neilgibsonpinto-art/Brushed-esc/stmesc.csv

Reference | Qty | Value | Footprint
C1,C2 | 2 | 270uF 35V | Capacitor_SMD:CP_Elec_8x10.5 | https://rajivelectronics.com/product/220-f-35v-smd-aluminum-electrolytic-capacitor
C3,C4 | 2 | 100nF 50V | Capacitor_SMD:C_0603_1608Metric | https://robu.in/product/100nf-603-surface-mount-multilayer-ceramic-capacitorreel-of-4000/
C7 | 1 | 22uF | Capacitor_SMD:C_0603_1608Metric | https://robu.in/product/cl10a226mp8nune-samsang-10v-22uf-x5r-%C2%B120-0603-multilayer-ceramic-capacitors-mlcc-smd-smt-rohs/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
C8 | 1 | 100nF | Capacitor_SMD:C_0603_1608Metric | https://robu.in/product/100nf-0603-surface-mount-multilayer-ceramic-capacitor-pack-of-40/
C9 | 1 | 1uF | Capacitor_SMD:C_0603_1608Metric | https://robu.in/product/0603b105k250nt-fh-25v-1uf-x7r%c2%b110-0603-multilayer-ceramic-capacitors-mlcc-smd-smt-rohs/
C10,C11 | 2 | 10nF | Capacitor_SMD:C_0603_1608Metric | https://robu.in/product/10nf-0603-surface-mount-multilayer-ceramic-capacitor-pack-of-50/
C12,C20 | 2 | 100nf | Capacitor_SMD:C_0603_1608Metric | https://robu.in/product/100nf-0603-surface-mount-multilayer-ceramic-capacitor-pack-of-40/
C13 fp issue make 0805 | 1 | 22uf/35v | Capacitor_SMD:C_0603_1608Metric | https://robu.in/product/grm21bc81c226me44l-murata-electronics-16v-22uf-x6s-%c2%b120-0805-multilayer-ceramic-capacitors-mlcc-smd-smt-rohs/
C14,C15 | 2 | 10uf | Capacitor_SMD:C_0603_1608Metric | https://robu.in/product/grm188d71a106ka73d-murata-electronics-10v-10uf-x7t-%c2%b110-0603-multilayer-ceramic-capacitors-mlcc-smd-smt-rohs-2/
C16 | 1 | 0.1uf | Capacitor_SMD:C_0603_1608Metric | https://robu.in/product/ac0603jrx7r9bb104-yageo-cap-ceramic-0-1uf-50v-x7r-5-pad-smd-0603-125c-automotive-aec-q200-t-r/
C21,C22 | 2 | 22uf | Capacitor_SMD:C_0603_1608Metric | https://robu.in/product/cl10a226mp8nune-samsang-10v-22uf-x5r-%c2%b120-0603-multilayer-ceramic-capacitors-mlcc-smd-smt-rohs/
D1,D4,D5 | 3 | LED | LED_SMD:LED_0805_2012Metric | https://robu.in/product/0805-surface-mount-led-red-50-pcs/
D3 | 1 | (15V Zener) | Diode_SMD:D_SOD-123 | https://robu.in/product/bzt52c15-mdd-independent-13-8v15-6v-500mw-15v-sod-123-zener-diodes-rohs/
J2,J3,J5 | 3 | Conn_01x02 | TerminalBlock_Phoenix:TerminalBlock_Phoenix_MKDS-1,5-2-5.08_1x02_P5.08mm_Horizontal | https://robu.in/product/xy306a-5-0-xinya-2-pin-screw-terminal-blockblue/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
J4 | 1 | Conn_01x06 | Connector_PinHeader_2.54mm:PinHeader_1x06_P2.54mm_Vertical
J6 | 1 | Conn_02x03_Odd_Even | Connector_PinHeader_2.54mm:PinHeader_2x03_P2.54mm_Vertical
L1 | 1 | 4.7uH | Inductor_SMD:L_Sunlord_SWPA5040S | https://evelta.com/4-7uh-3a-20-39mohm-inductor-smd/
Q2 | 1 | IRFR5305 | Package_TO_SOT_SMD:TO-252-2 | https://robu.in/product/irfr5305-slkor-60v-30a-35m%CF%8910v-50w-2-5v-1-piece-p-channel-to-252-mosfets-rohs/
R1,R4,R5,R6,R7,R10,R11,R12,R15,R16 | 10 | 1k | Resistor_SMD:R_0603_1608Metric | https://robu.in/product/1k-ohm-1-4w-0603-surface-mount-chip-resistor-pack-of-100/
R2,R3,R9,R14 | 4 | 10k | Resistor_SMD:R_0603_1608Metric | https://robu.in/product/10k-ohm-1-4w-0603-surface-mount-chip-resistor-pack-of-100/
R8,R13 | 2 | 1k 1% | Resistor_SMD:R_0603_1608Metric
R17 | 1 | 100K | Resistor_SMD:R_0603_1608Metric | https://robu.in/product/100k-ohm-1-4w-0603-surface-mount-chip-resistor-pack-of-100/
SW1,SW2,SW3 | 3 | SW_Push | Button_Switch_SMD:SW_SPST_TS-1088-xR025 | https://robu.in/product/1-month-warranty-470/
U1,U2 | 2 | VNH7070BASTR | Package_SO:SOIC-16_3.9x9.9mm_P1.27mm | https://robu.in/product/vnh7070bastr-stmicroelectronics-motor-driver-controller-h-bridge-1-output-4-v-to-28-v-supply-15-a-out-nsoic-16/
U3 | 1 | ESP32-WROOM-32E | RF_Module:ESP32-WROOM-32D
U5 | 1 | AMS1117-3.3 | Package_TO_SOT_SMD:SOT-223-3_TabPin2
U6 | 1 | AP63205WU-7 | neil:SOIC_05WU-7_DIO-M
