neilgibsonpinto-art/Brushed-esc/stmesc.step

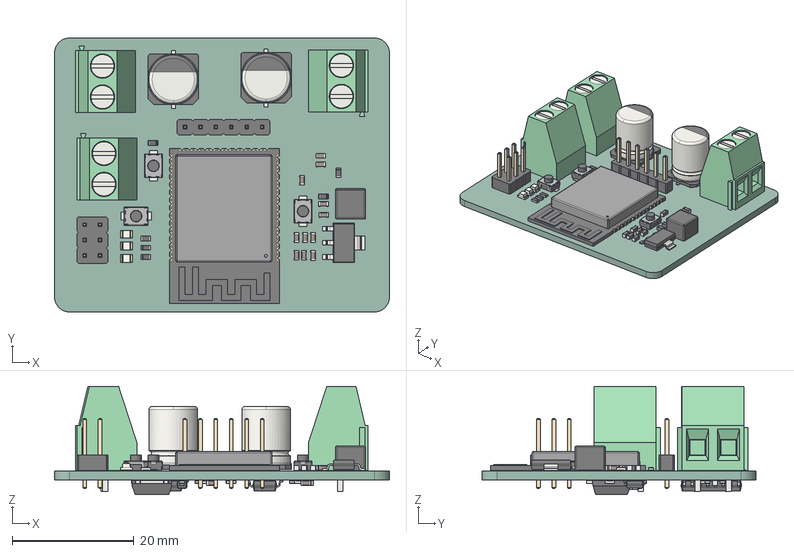
[picture p3: CAD file, 2026-10-21]
stmesc.step
55.0 x 45.0 x 17.8 mm
SW_SPST_TS-1088-xR025 x 3
TerminalBlock_Phoenix_MKDS-1,5-2-5.08_1x02_P5.08mm_Horizontal x 3
C_0603_1608Metric x 15
R_0603_1608Metric x 17
PinHeader_2x03_P254mm_Vertical
SOT-223
LED_0805_2012Metric x 3
PinHeader_1x06_P254mm_Vertical
a69dfe88-8551-11ed-a139-00155d22e2d7_part
a69dffdc-8551-11ed-a139-00155d22e2d7_part
a69e005e-8551-11ed-a139-00155d22e2d7_part
CP_Elec_8x105 x 2
ESP32-S3-WROOM-2
SOIC-16_3.9x9.9mm_P1.27mm x 2
D_SOD-123
932d09b3-9c39-11ed-93f0-dde97e994e83_part
932d09b4-9c39-11ed-93f0-dde97e994e83_part
932d09b5-9c39-11ed-93f0-dde97e994e83_part
stm632D_PCB
