neilgibsonpinto-art/Brushed-esc/stmesc.kicad_pcb

## KiCad design stmesc.kicad_pcb (2026-10-21)

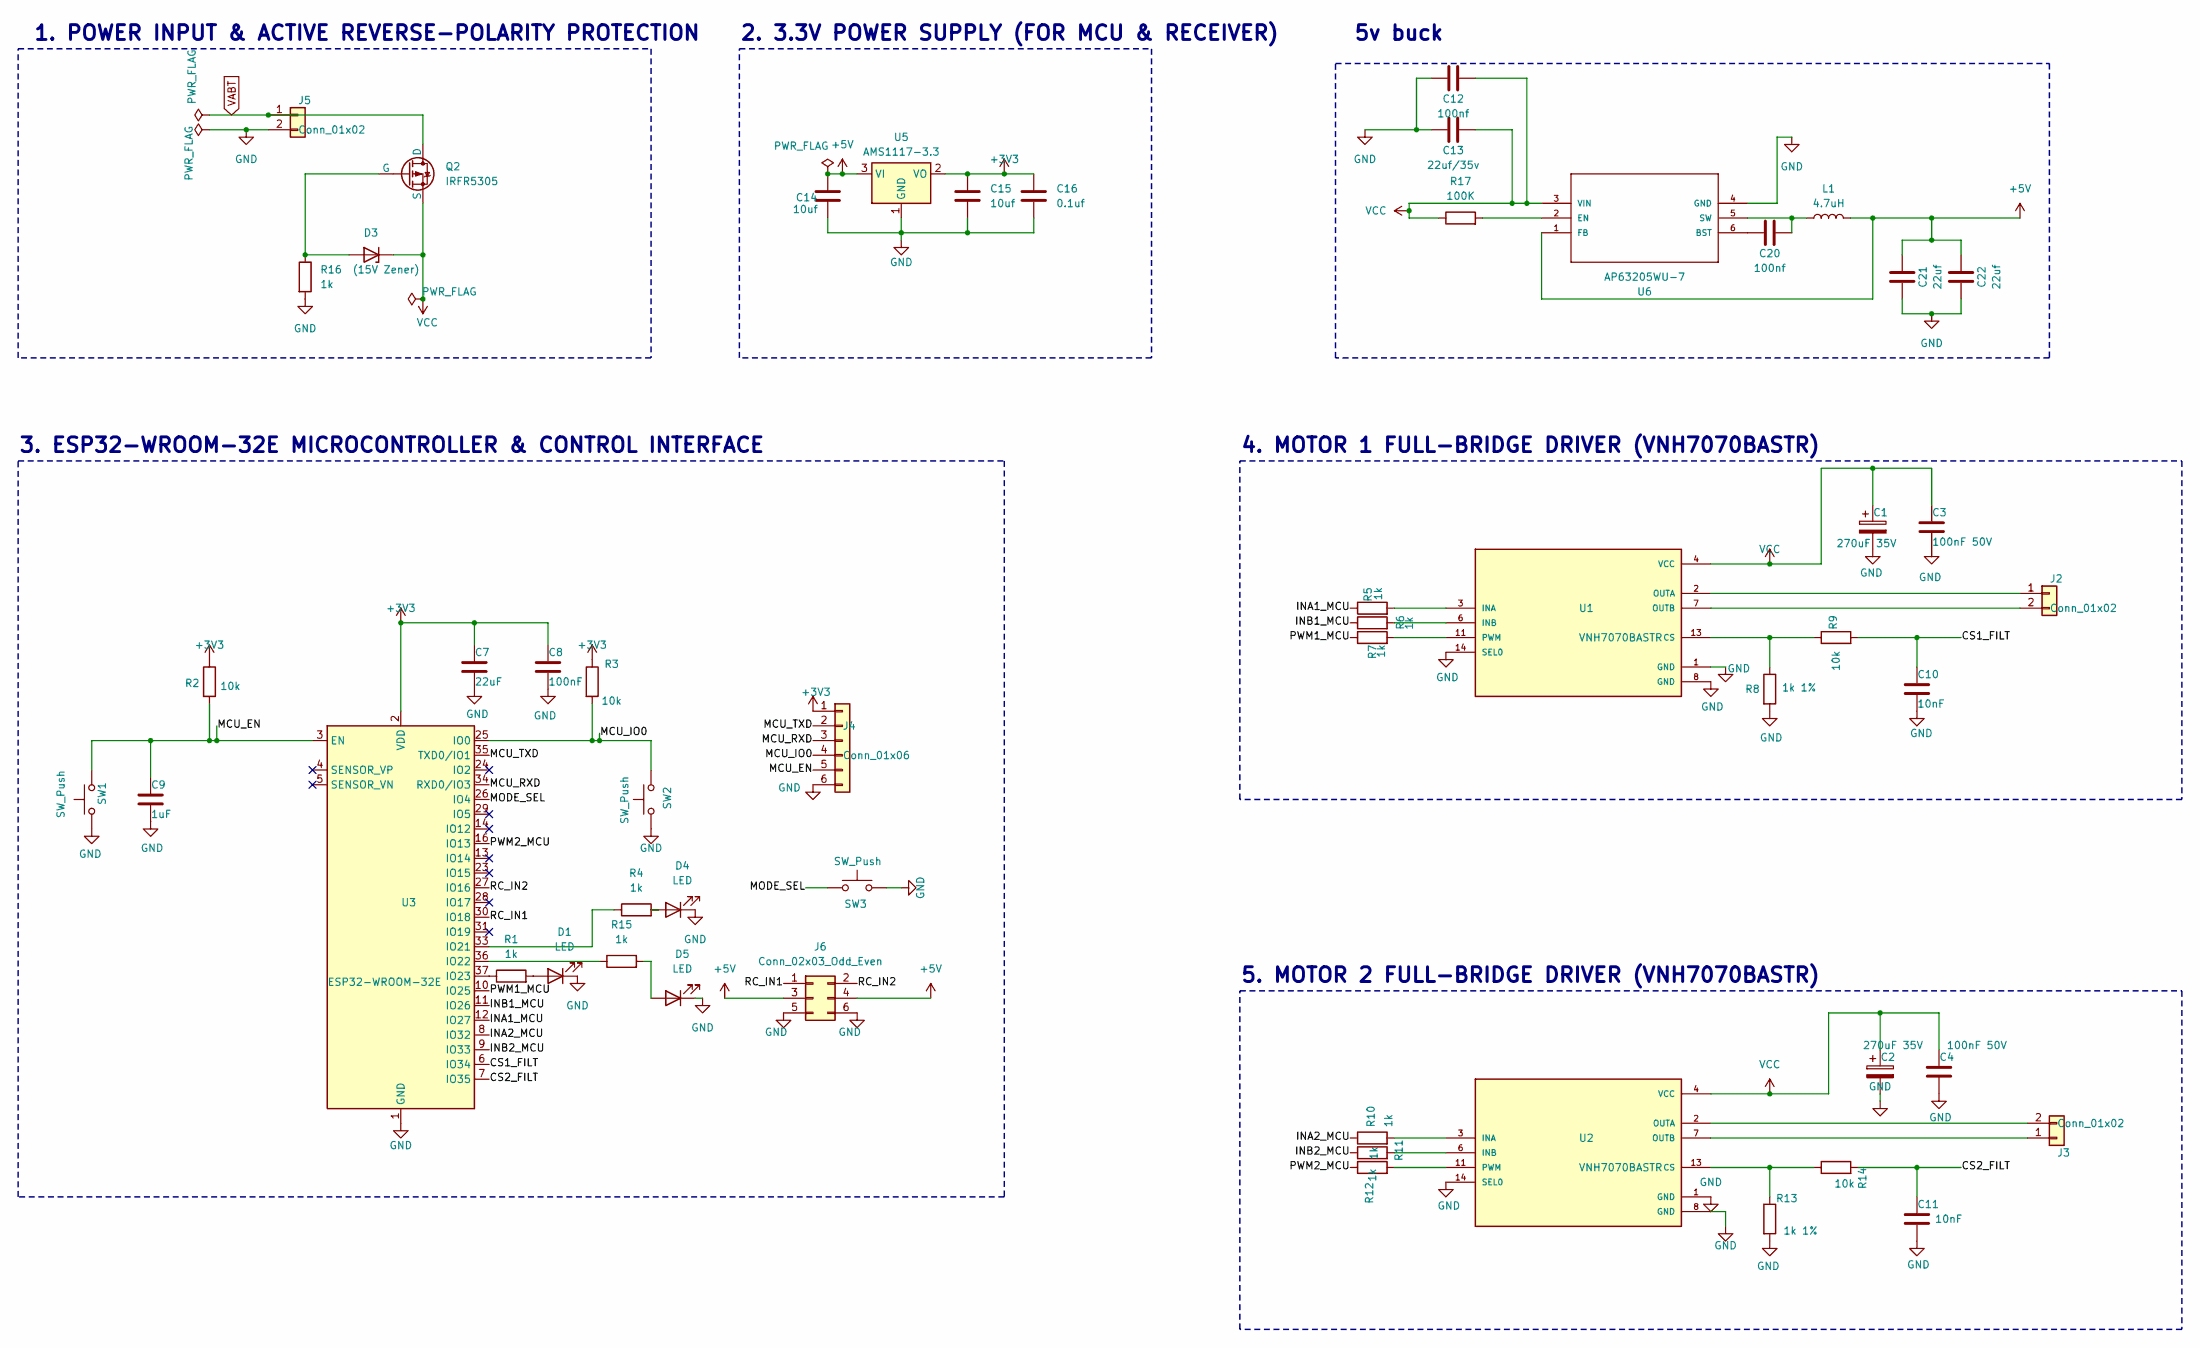
[picture p6: schematic stmesc.kicad_sch, Dual-Motor Brushed ESC (STMESC)]

Parts:
C1, C2: 270uF 35V; CP_Elec_8x10.5
C3, C4: 100nF 50V; C_0603_1608Metric
C7: 22uF; C_0603_1608Metric
C8: 100nF; C_0603_1608Metric
C9: 1uF; C_0603_1608Metric
C10, C11: 10nF; C_0603_1608Metric
C12, C20: 100nf; C_0603_1608Metric
C13: 22uf/35v; C_0603_1608Metric
C14, C15: 10uf; C_0603_1608Metric
C16: 0.1uf; C_0603_1608Metric
C21, C22: 22uf; C_0603_1608Metric
D1, D4, D5: LED; LED_0805_2012Metric
D3: (15V Zener); D_SOD-123
J2, J3, J5: Conn_01x02; TerminalBlock_Phoenix_MKDS-1,5-2-5.08_1x02_P5.08mm_Horizont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
J4: Conn_01x06; PinHeader_1x06_P2.54mm_Vertical
J6: Conn_02x03_Odd_Even; PinHeader_2x03_P2.54mm_Vertical
L1: 4.7uH; L_Sunlord_SWPA5040S
Q2: IRFR5305; TO-252-2
R1, R4, R5, R6, R7, R10, R11, R12, R15, R16: 1k; R_0603_1608Metric
R2, R3, R9, R14: 10k; R_0603_1608Metric
R8, R13: 1k 1%; R_0603_1608Metric
R17: 100K; R_0603_1608Metric
SW1, SW2, SW3: SW_Push; SW_SPST_TS-1088-xR025
U1, U2: VNH7070BASTR; SOIC-16_3.9x9.9mm_P1.27mm
U3: ESP32-WROOM-32E; ESP32-WROOM-32D
U5: AMS1117-3.3; SOT-223-3_TabPin2
U6: AP63205WU-7; SOIC_05WU-7_DIO-M; MPN AP63205WU-7

Connections:
+3V3: C7.1, C8.1, C15.1, C16.1, J4.1, R2.1, R3.1, U3.2 (VDD), U5.2 (VO)
+5V: C14.1, C21.2, C22.2, J6.3, J6.4, L1.2, U5.3 (VI), U6.1 (FB)
/CS1_FILT: C10.1, R9.2, U3.6 (IO34)
/CS2_FILT: C11.1, R14.2, U3.7 (IO35)
/INA1_MCU: R5.1, U3.12 (IO27)
/INA2_MCU: R10.1, U3.8 (IO32)
/INB1_MCU: R6.1, U3.11 (IO26)
/INB2_MCU: R11.1, U3.9 (IO33)
/MCU_EN: C9.1, J4.5, R2.2, SW1.2, U3.3 (EN)
/MCU_IO0: J4.4, R3.2, SW2.2, U3.25 (IO0)
/MCU_RXD: J4.3, U3.34 (RXD0/IO3)
/MCU_TXD: J4.2, U3.35 (TXD0/IO1)
/MODE_SEL: SW3.2, U3.26 (IO4)
/PWM1_MCU: R7.1, U3.10 (IO25)
/PWM2_MCU: R12.1, U3.16 (IO13)
/RC_IN1: J6.1, U3.30 (IO18)
/RC_IN2: J6.2, U3.27 (IO16)
unnamed: D1.2 (A), R1.2
unnamed: D3.2 (A), Q2.2 (G), R16.1
unnamed: D4.2 (A), R4.2
unnamed: D5.2 (A), R15.2
unnamed: J2.1, U1.2 (OUTA), U1.15 (OUTA)
unnamed: J2.2, U1.7 (OUTB), U1.10 (OUTB)
unnamed: J3.1, U2.7 (OUTB), U2.10 (OUTB)
unnamed: J3.2, U2.2 (OUTA), U2.15 (OUTA)
unnamed: R8.1, R9.1, U1.13 (CS)
unnamed: R5.2, U1.3 (INA)
unnamed: R6.2, U1.6 (INB)
unnamed: R7.2, U1.11 (PWM)
unnamed: R13.1, R14.1, U2.13 (CS)
unnamed: R10.2, U2.3 (INA)
unnamed: R11.2, U2.6 (INB)
unnamed: R12.2, U2.11 (PWM)
unnamed: R4.1, U3.33 (IO21)
unnamed: R15.1, U3.36 (IO22)
unnamed: R1.1, U3.37 (IO23)
unnamed: C20.1, U6.6 (BST)
unnamed: R17.2, U6.2 (EN)
unnamed: C20.2, L1.1, U6.5 (SW)

Notes on the sheet:
5. MOTOR 2 FULL-BRIDGE DRIVER (VNH7070BASTR)
4. MOTOR 1 FULL-BRIDGE DRIVER (VNH7070BASTR)
2. 3.3V POWER SUPPLY (FOR MCU & RECEIVER)
3. ESP32-WROOM-32E MICROCONTROLLER & CONTROL INTERFACE
5v buck
1. POWER INPUT & ACTIVE REVERSE-POLARITY PROTECTION

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
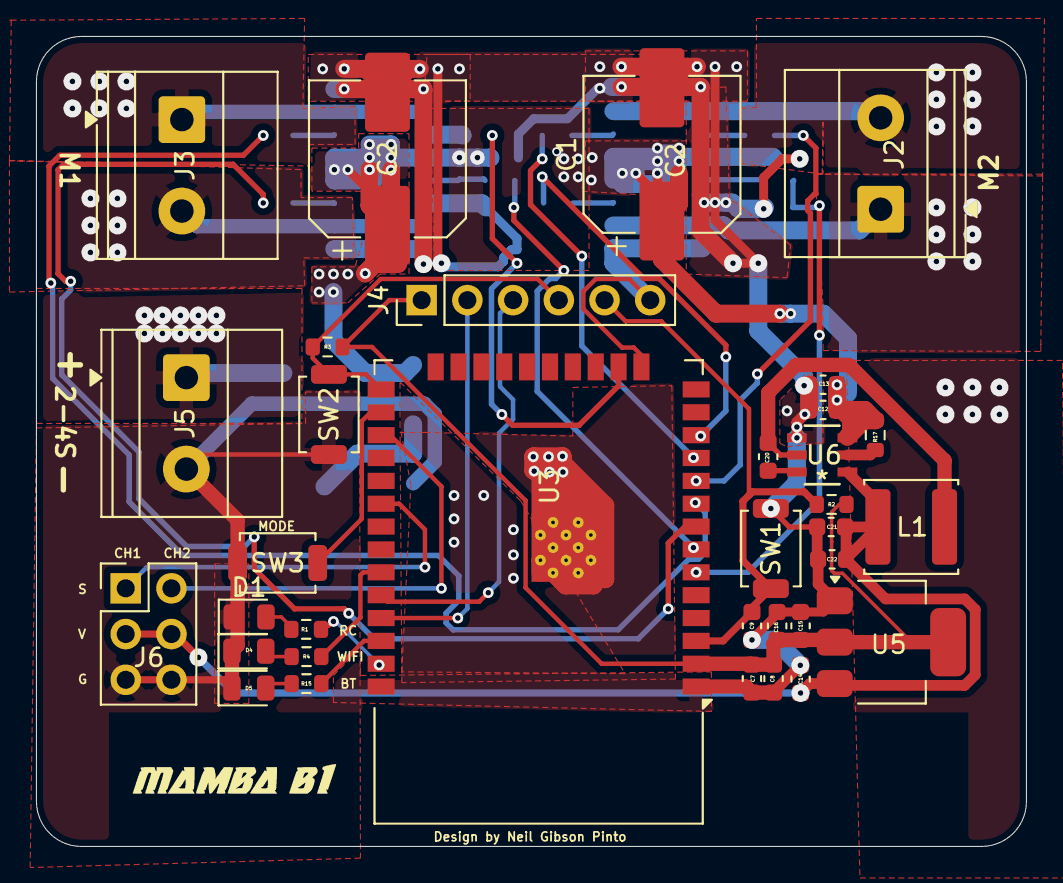
[picture p7: board stmesc.kicad_pcb from above]

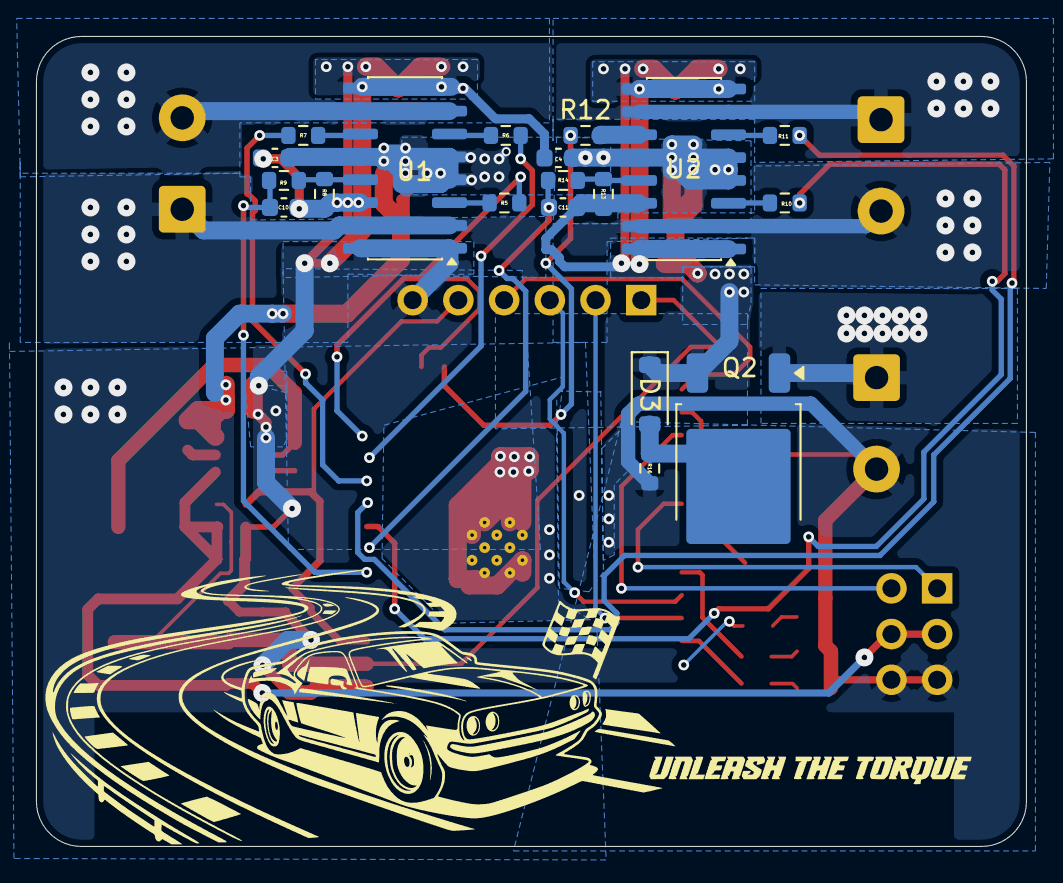
[picture p8: board stmesc.kicad_pcb from below]

Board: 2 copper layers, 55.0 x 45.0 mm, 53 parts (19 on the bottom side), 42 nets.
